danielsauter/quartz/README.md

# Quartz

### Hexo Source Code 

hexo init
hexo generate
hexo deploy
