danielsauter/quartz/source/README.md

# CNC
X Carve Documents and G-Code control

Folders
- GCODE : Testing files
- Models : CAD Files for XCarve. Built from 500mmX500mm model. Tolerances may vary.
- Scripts : Python & Grasshopper files
- UniversalGCodeSender : To manually send GCode to XCarve

Next tests:
- Faulty Y Limit Switch
- Movement in 3D
- Make 3D Printer mount**
- Extruder to GRBL Connections*

Base plate & temperature controller

*Difficulty/Time Investment
