danielsauter/quartz/source/_posts/4- CAD Models.md

---
title: CAD Models
date: 6/4/2016
---
<!-- more -->
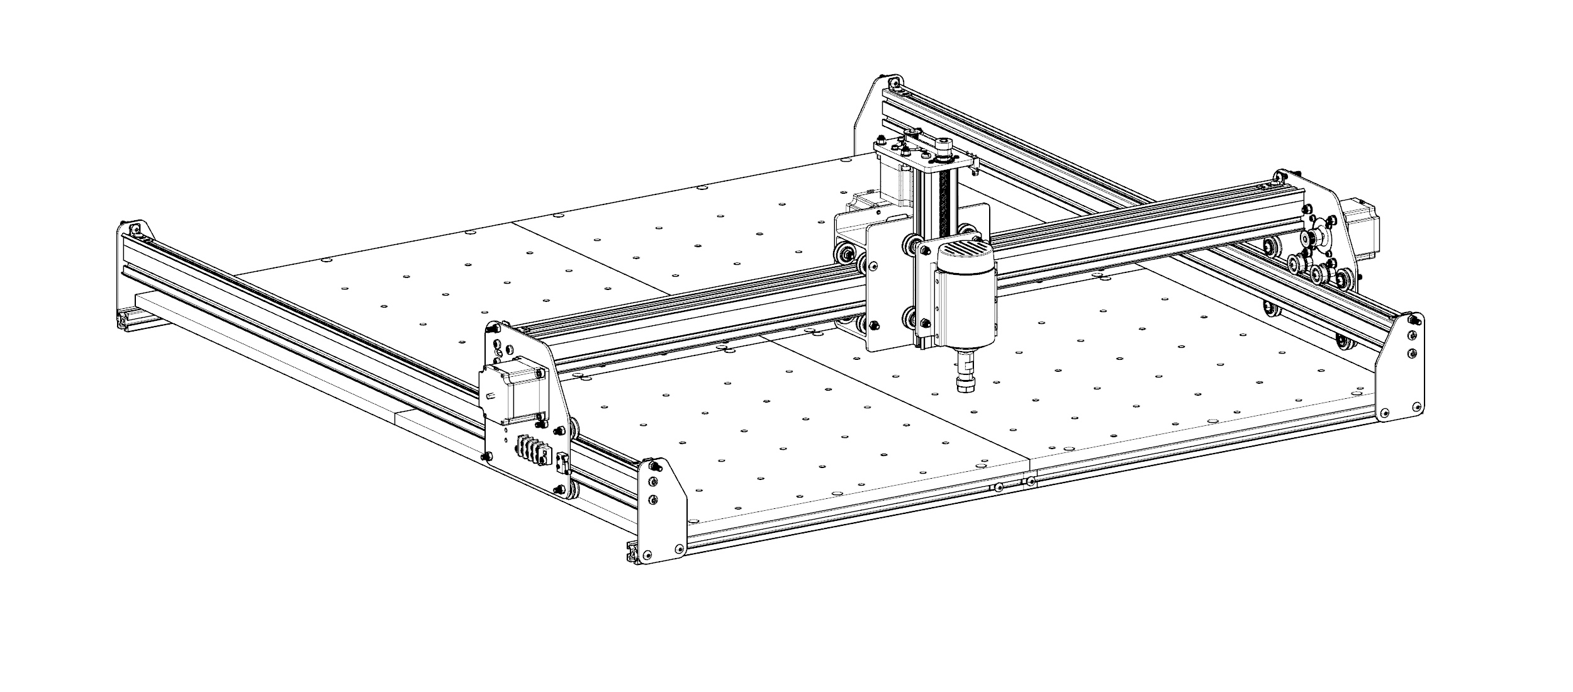
[picture p3: source/images/XCarve1000.jpg]


# X Carve 1000mm

The model for the X-Carve 1000mm and its parts is available on [GrabCAD Workbench](https://workbench.grabcad.com/workbench/projects/gcl5zpCuwqCXWLvYktLQBc-2IHvossNo37ycTOkzg6gREW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)

* * *

# Extruder Original CAD
The reference file for the 3D printer extruder was taken from [GrabCAD Library](https://grabcad.com/library/china-extruder-for-3d-printer-from-aliexpress-1)

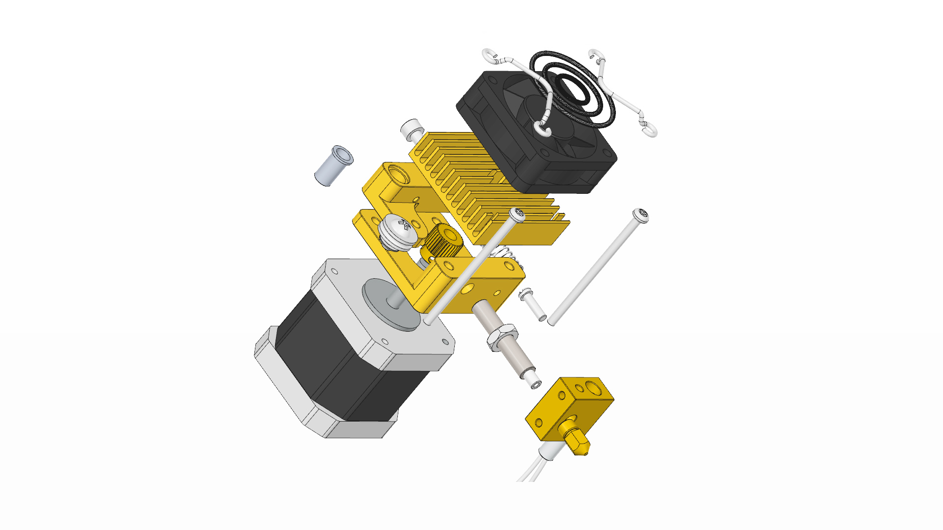
[picture p4: source/images/Extruder grabcad.jpg]
GrabCad Extruder


* * *

# Extruder Modification
The extruder will require to be machined in order to enlarge the feed and extrusion openings. More details can be found in the linked CAD files. It is highly recommended to carry out your own measurements specific to the extruder you own. These drawings are intended to provide a guide to share the required modifications. 
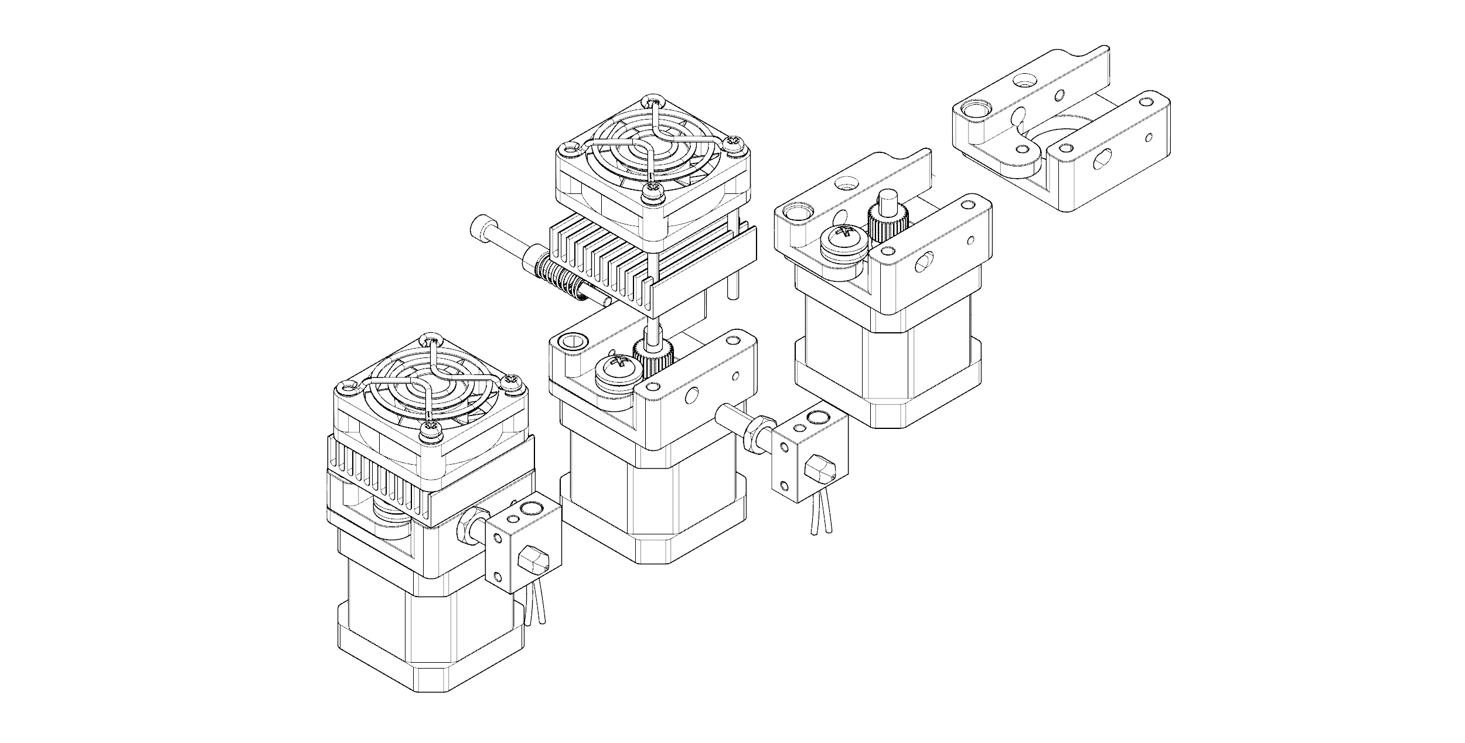
[picture p5: source/images/Extruder Mod.jpg]
Extruder Modified

<iframe width="100%" height="480" src="https://sketchfab.com/models/ec986721a17f40f2b00fd561553fb349/embed" frameborder="0" allowfullscreen mozallowfullscreen="true" webkitallowfullscreen="true" onmousewheel=""></iframe>

[Download .3dm Rhino File](https://www.dropbox.com/s/v5pvn5o80edqq0c/extruder%20mod.3dm?dl=0)
[Download .stp Rhino File (without annotations)](https://www.dropbox.com/s/hwm30xc2ja88o7x/extruder%20mod.stp?dl=0)

* * *

# Aluminium Mounts for the Extruder
You'll need some basic experience for Lathe Machining. Please sought help from a workshop technician for extra help. The drawings are annotated with measurements in Rhino file. They may vary depending upon the model of your extruder and the glass rods you own. Again, these are closest possible representation of the hardware setup.
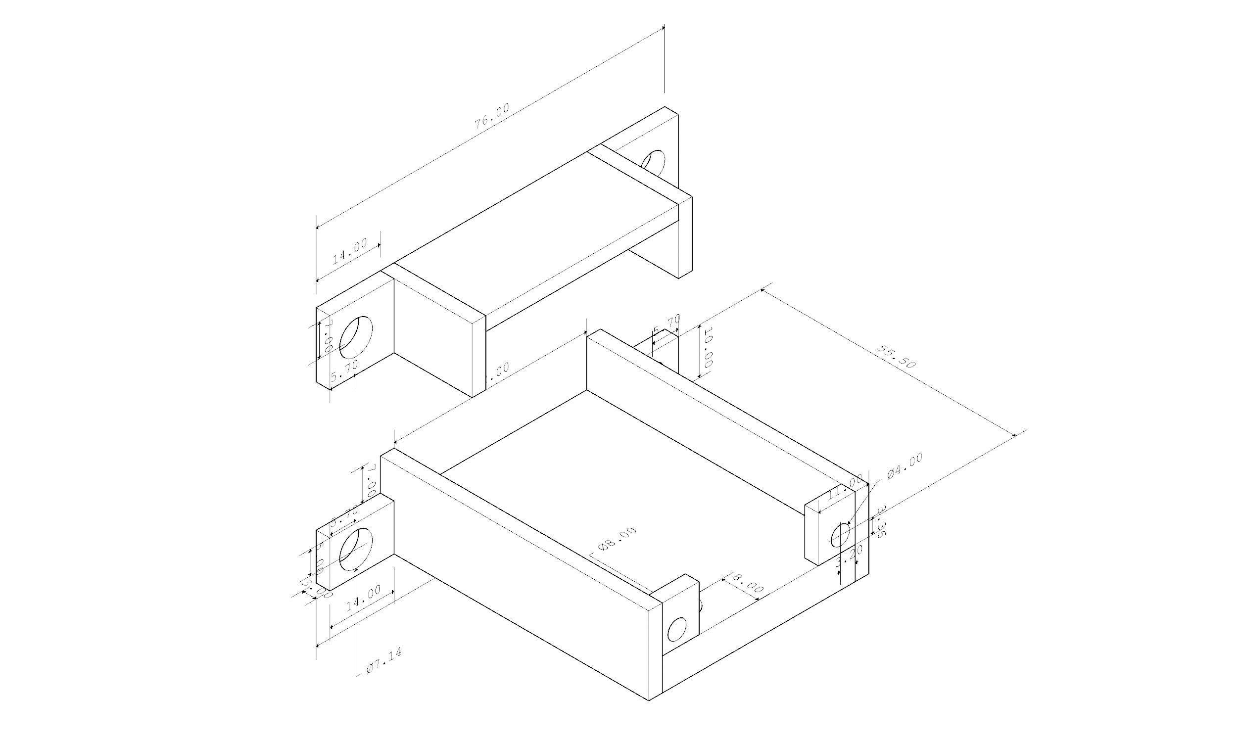
[picture p6: source/images/extruder mount.jpg]
Extruder Mount


<iframe width="100%" height="480" src="https://sketchfab.com/models/8a998a0730a74d8391d096257696d2f6/embed" frameborder="0" allowfullscreen mozallowfullscreen="true" webkitallowfullscreen="true" onmousewheel=""></iframe>

[Download .3dm Rhino File](https://www.dropbox.com/s/8g3itv43fneh8n2/extruder%20mount.3dm?dl=0)
[Download .stp Rhino File (without annotations)](https://www.dropbox.com/s/jf1a3pl2my2fpgk/extruder%20mount.stp?dl=0)

* * *

# Final Assembly
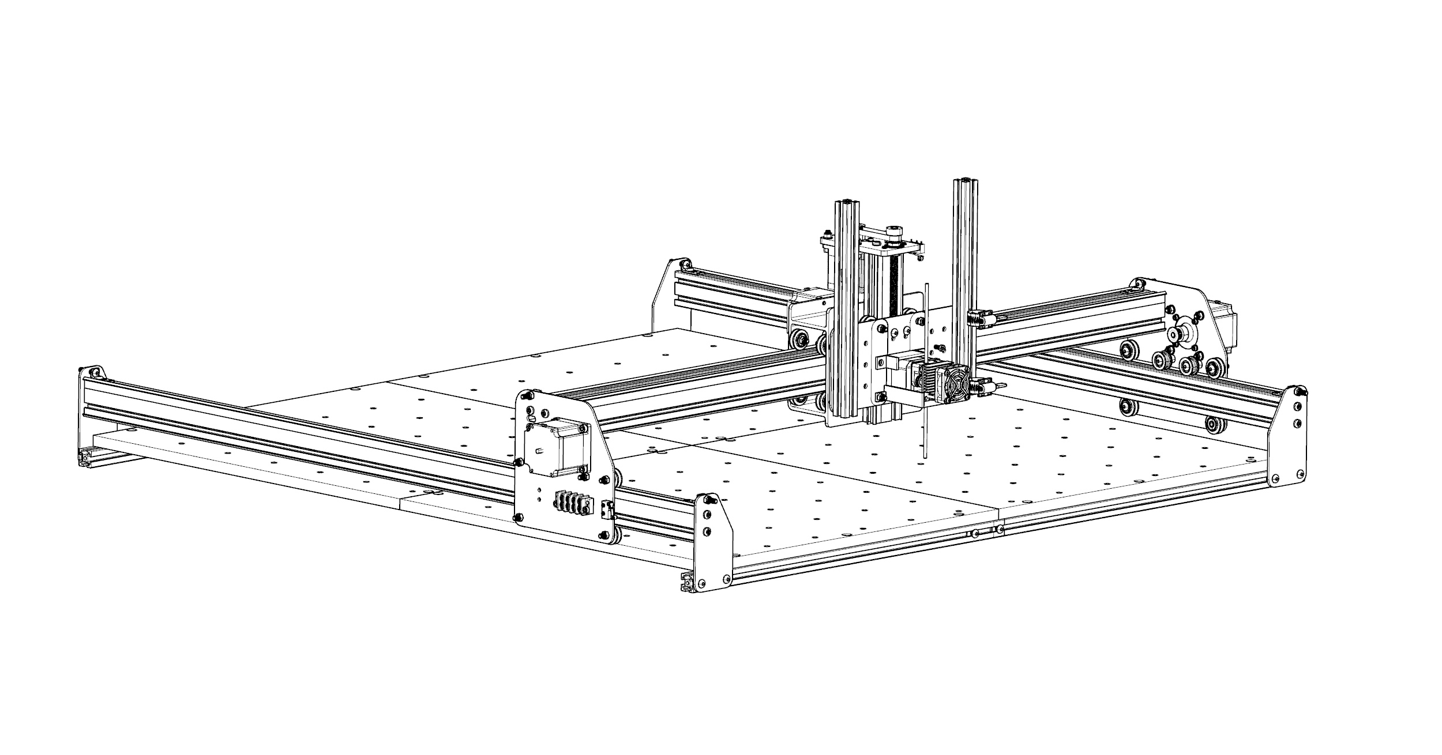
[picture p7: source/images/XCarve1000 mod.jpg]

[Download .3dm Rhino File](https://www.dropbox.com/s/xrf9nrrtaag5o8s/Xcarve_mod.3dm?dl=0)
