danielsauter/quartz/source/images/DSC08460.JPG

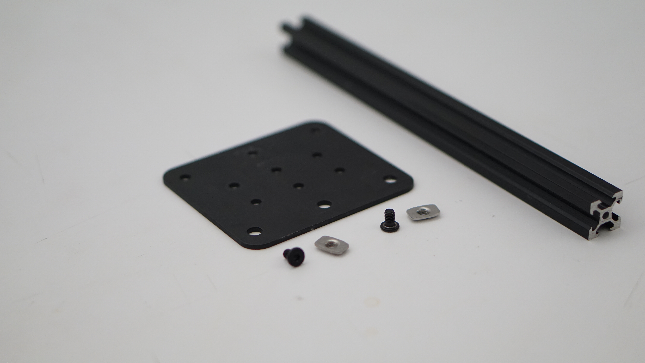
source/images/DSC08460.JPG
