danielsauter/quartz/source/images/DSC08463.JPG

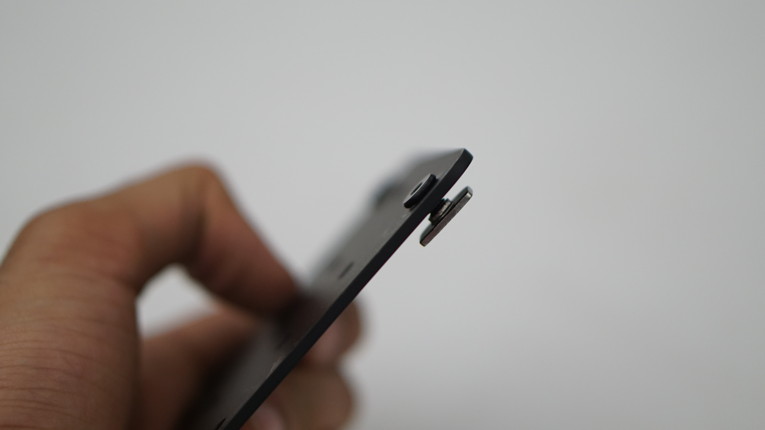
source/images/DSC08463.JPG
