danielsauter/quartz/source/images/DSC08465.JPG

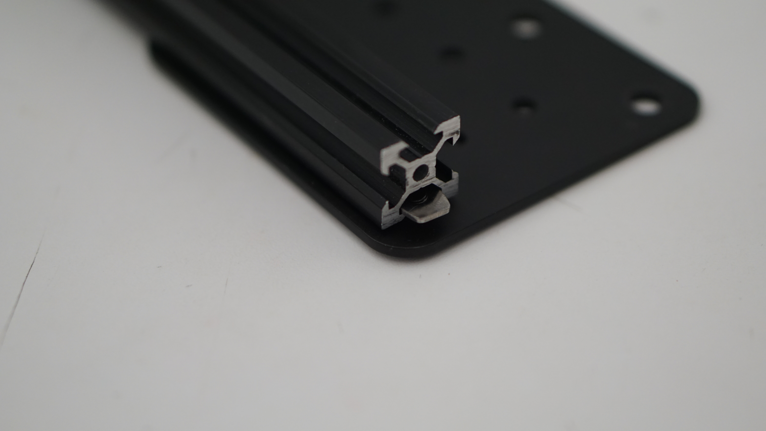
source/images/DSC08465.JPG
