danielsauter/quartz/source/images/DSC08470.JPG

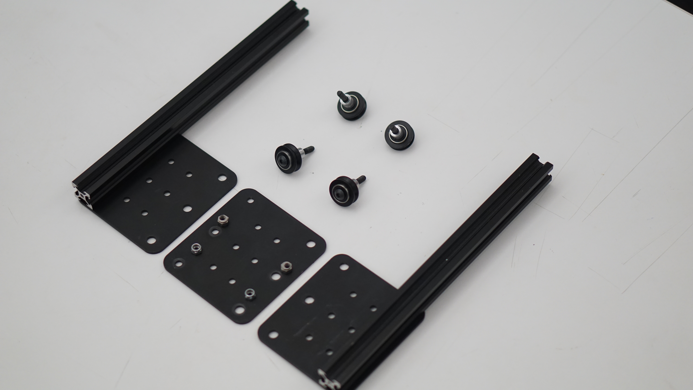
source/images/DSC08470.JPG
