danielsauter/quartz/source/images/DSC08473.JPG

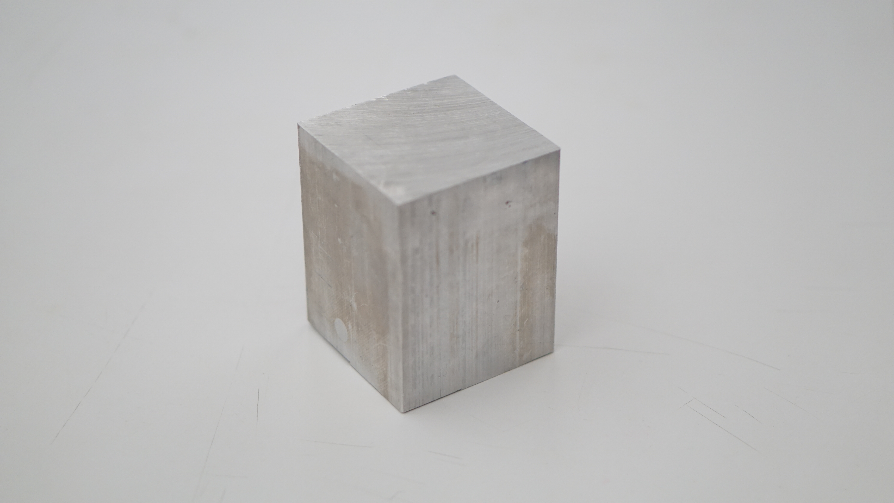
source/images/DSC08473.JPG
