danielsauter/quartz/source/images/DSC08480.JPG

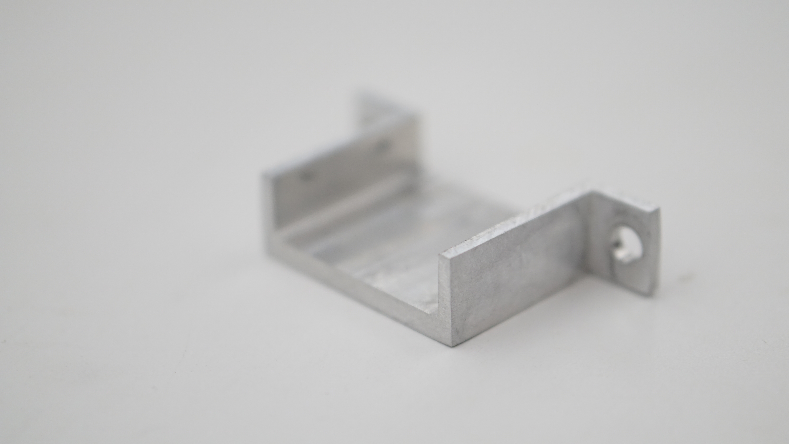
source/images/DSC08480.JPG
