danielsauter/quartz/source/images/DSC08518.JPG

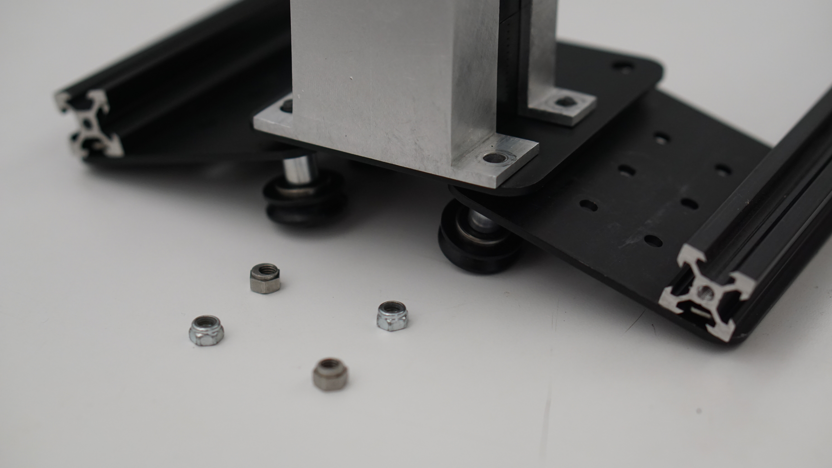
source/images/DSC08518.JPG
