danielsauter/quartz/source/images/DSC08522.jpg

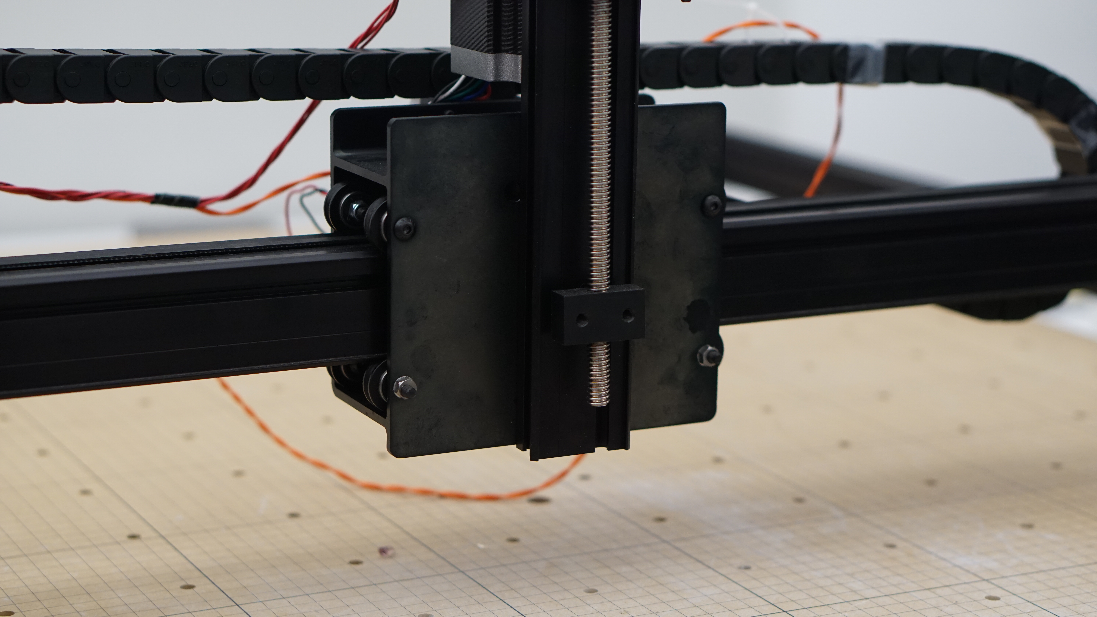
source/images/DSC08522.jpg
