danielsauter/quartz/source/images/DSC08523.JPG

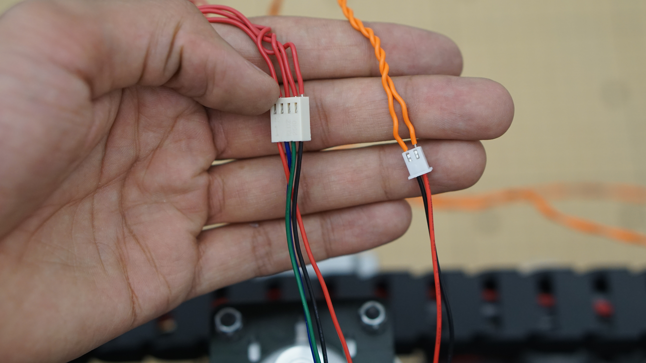
source/images/DSC08523.JPG
