danielsauter/quartz/source/images/DSC08533.JPG

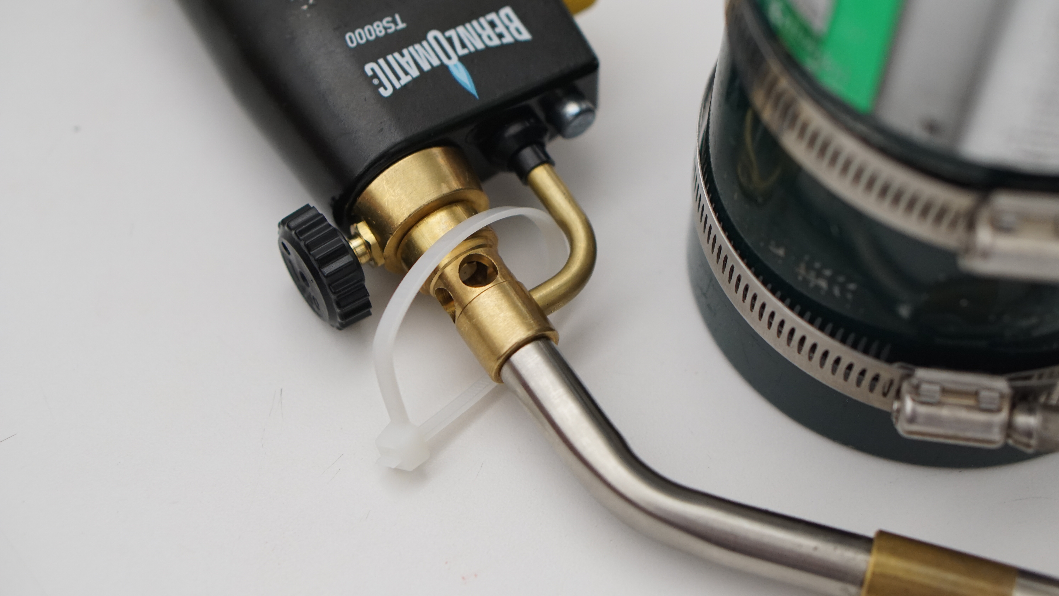
source/images/DSC08533.JPG
