danielsauter/quartz/source/images/DSC08534.JPG

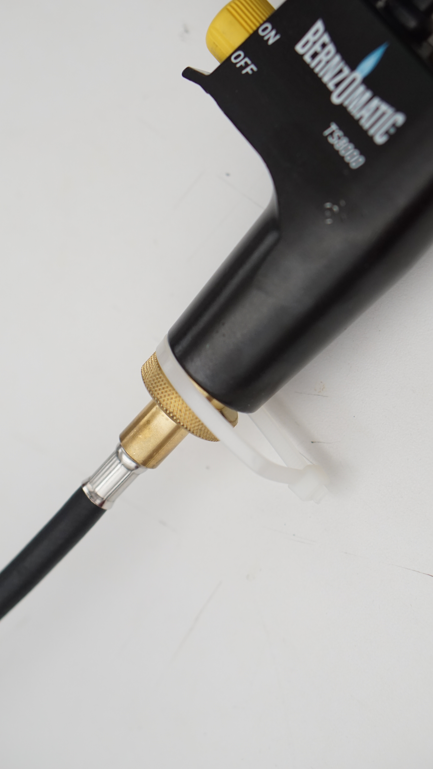
source/images/DSC08534.JPG
