danielsauter/quartz/source/images/DSC08536.JPG

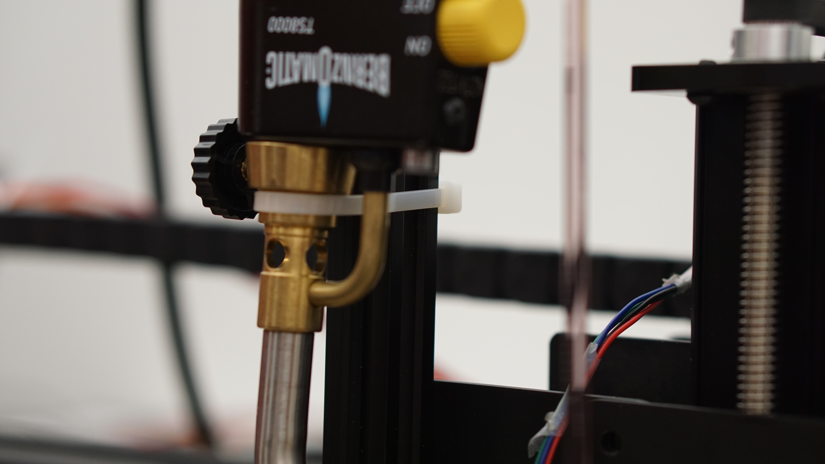
source/images/DSC08536.JPG
