danielsauter/quartz/source/images/DSC08538.JPG

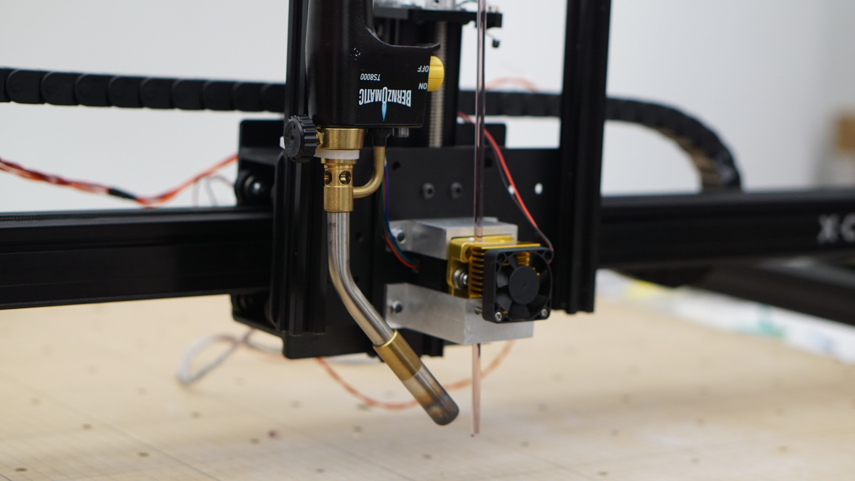
source/images/DSC08538.JPG
