danielsauter/quartz/source/images/DSC08548.JPG

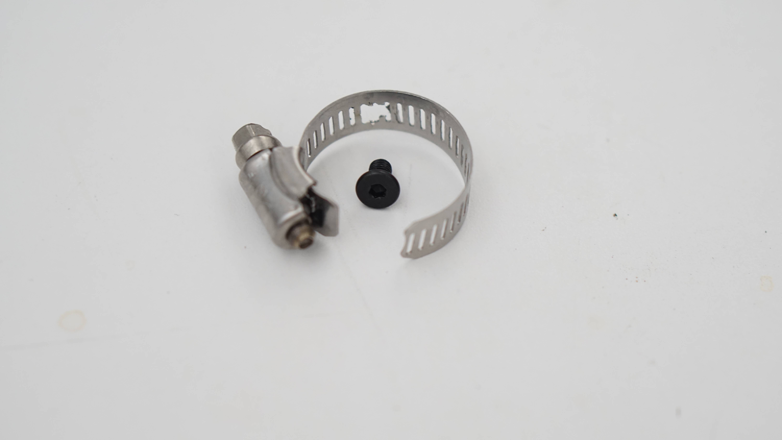
source/images/DSC08548.JPG
