danielsauter/quartz/source/images/DSC08551.JPG

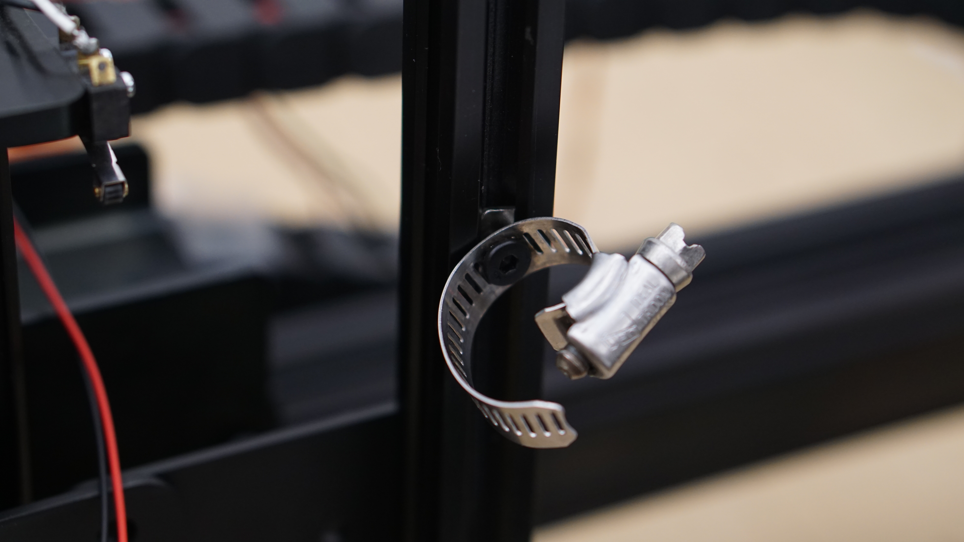
source/images/DSC08551.JPG
