danielsauter/quartz/source/images/DSC08552.JPG

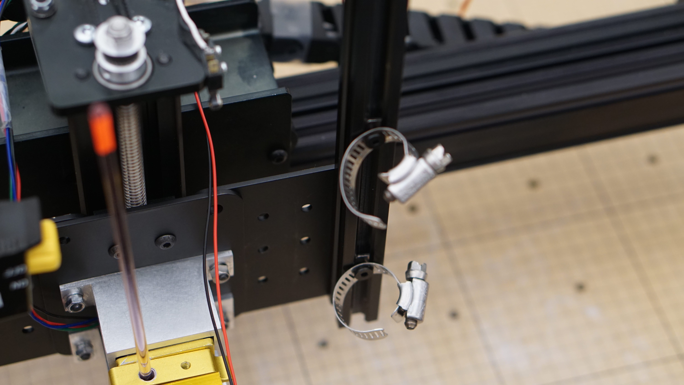
source/images/DSC08552.JPG
