danielsauter/quartz/source/images/extruder5.jpg

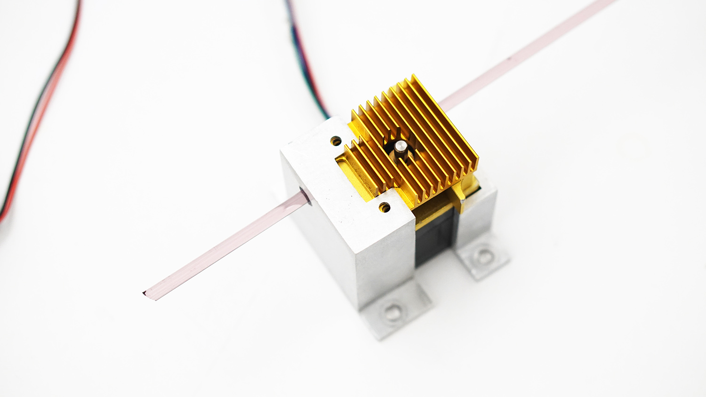
source/images/extruder5.jpg
