danielsauter/quartz/source/images/extruder6.jpg

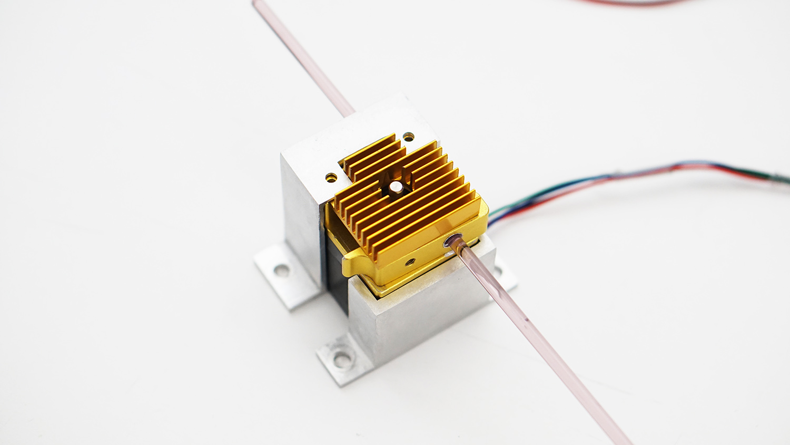
source/images/extruder6.jpg
