danielsauter/quartz/source/images/extruder7.jpg

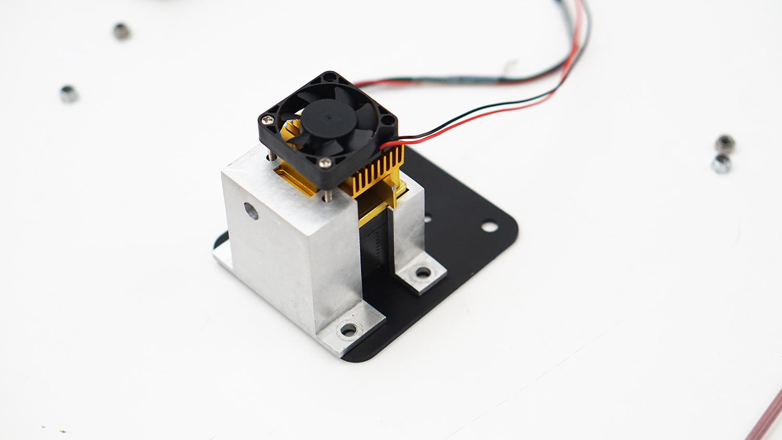
source/images/extruder7.jpg
