danielsauter/quartz/source/images/intro1.jpg

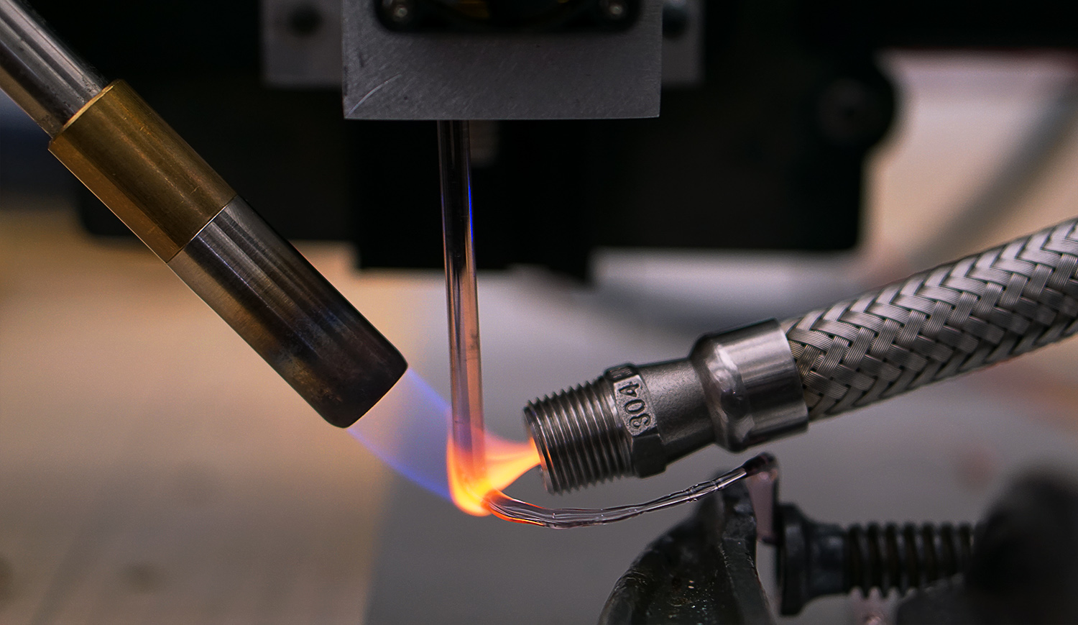
source/images/intro1.jpg
