danielsauter/quartz/source/images/tinyg.jpg

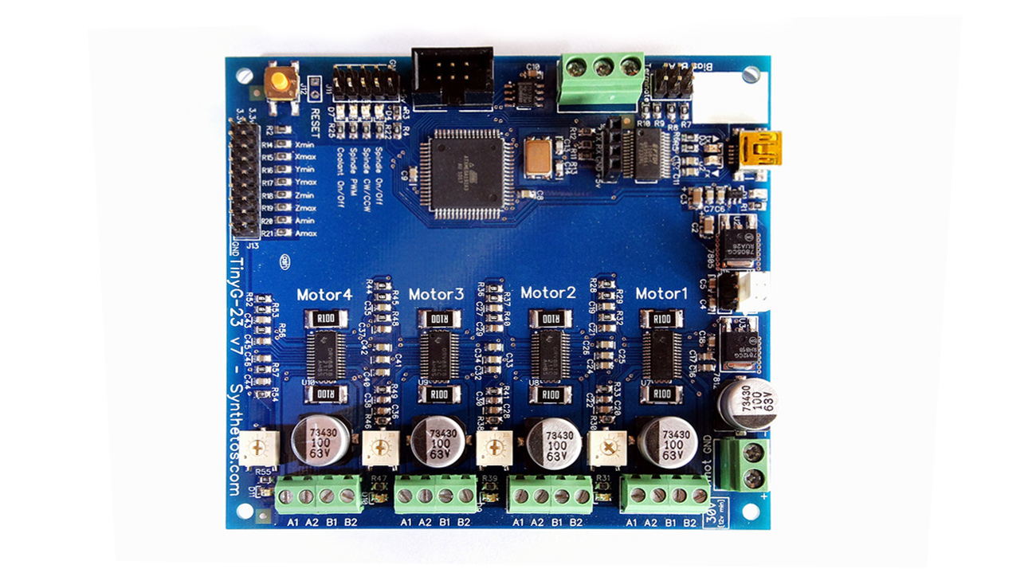
source/images/tinyg.jpg
