danielsauter/quartz/source/_posts/3- Parts List.md

---
title: Parts List
date: 6/5/2016
---

- [X-Carve Machine](https://www.inventables.com/technologies/x-carve/customize#fully-loaded)
	You may order one without the Spindle and Motion Controller.
	This project is based on following configuration:
	- 1000mm Rail Kit
	- ACME Lead Screw Kit

- [TinyG Motion Controller](http://synthetos.myshopify.com/products/tinyg)

- 3X [Spindle Mounting Plates](https://www.inventables.com/technologies/spindle-mounting-plate)
	- Part Number: 30287-01

- 1X [500mm Aluminum Extrusion](https://www.inventables.com/technologies/aluminum-extrusion-20mm-x-20mm-black)
	- Part Number: 26049-01
	- Manually cut in 250mm Halves

- 1X Pack of [Tslot screws](https://www.inventables.com/technologies/pre-assembly-t-slot-nuts)
	- Pitch: 0.5mm
	- Part Number: 25281-01
- 1X Pack of [Button Head Cap Screw](https://www.inventables.com/technologies/button-head-cap-screw?recommended=product)
	- Length: 16mm
	- Pitch: 0.5mm
	- Part Number: 25286-11

- 1X Pack of [Nylon Insert Lock Nut](https://www.inventables.com/technologies/nylon-insert-lock-nut)
	- Part Number: 30265-02
	- Pitch: 0.5mm

- [Multipurpose 6061 Aluminum](http://www.mcmaster.com/#9008k62/=1165kyw) ( Link to CAD Models)
	- Rectangular Bar 3"x3"x6"
	- Part Number: 9008K62

- [3D printer Extruder](https://www.amazon.com/Sintron-Printer-Extruder-Upgrade-MakerBot/dp/B00SLL9OO8/189-9506836-5291546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)

- 1X [Seat washer](http://www.homedepot.com/p/DANCO-1-4-in-Faucet-Seat-Washers-for-Price-Pfister-80359/203193501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)
	- 1/4" Faucet Seat Washer
	- Model Number: 80359
	- Part Number: 711262

- [Glass rods](http://www.mcmaster.com/#8496k22/=12wav0h)
	- Part Number: 8496K22
	- *This project used a locally sourced sampler set of approximately same specifications.
 
- [Vaccon Ventrui Pump](http://www.vaccon.com/CDF-Home.aspx)
	- Model Number: CDF-375H
	- Silencer Optional

- NPT Fittings (May be available in local hardware stores)
	- [Watts LFA-16 Compression Coupling](https://www.amazon.com/Watts-LFA16-Compression-Female-Adapter/dp/B004VT3ZYO)
		- 1/4" OD x 1/4" FIP
	- [Industrial Shape Hose Coupling](http://www.mcmaster.com/#6718K26)
		- 1/4" NPTF Male
		- Part Number: 6718K26
	- [AllstarBrass Straight Inverted Flare Female Brake Line Adapter Fitting](https://www.amazon.com/gp/product/B006K8MH2U/ref=od_aui_detailpages00?ie=UTF8&psc=1)
		- 1/8" NPT Male to 1/4" 
		- Part Number: ALL50121 

- [High Temperature Corrosion Resistant Braided Hose](http://www.mcmaster.com/#5680K12)
	- Flexible, 3/8 NPT Male Fittings
	- Part Number: 5680K12
	- Length 72" and up

- [Propane Tank](http://www.bernzomatic.com/product/ts916-16-4-oz-propane-camping-cylinder/)
	- Model: TX-916
- [Trigger Start Torch](http://www.bernzomatic.com/product/ts8000bzkc-high-intensity-trigger-start-torch-kit/)
	- Model: TS8000BZKC

- 1X Pack [Hose Clamps](http://www.mcmaster.com/#5362k12/=12wbx5l)
	- 3/4" ID
	- Part Number: 5362K12

- G-Clamps 

- Zipties

- [Air Compressor](https://www.amazon.com/PORTER-CABLE-C3151-OILFREE-COMPRESSOR/dp/B001DUNC3I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)
	- Model Number: Porter-Cable C3151
	- Capacity: 4.5 GALLON 150 PSI 

Notes: 
These parts are an indication of what was used and tested during the documentation of this project. Feel free to experiment with different designs and materials.
