danielsauter/quartz/(list of files, cad)

Other CAD files:
Scripts/Grasshopper Shopbot Writer/Dimple_halftone_outline.3dm
