danielsauter/quartz/source/images/Assemble (3).JPG

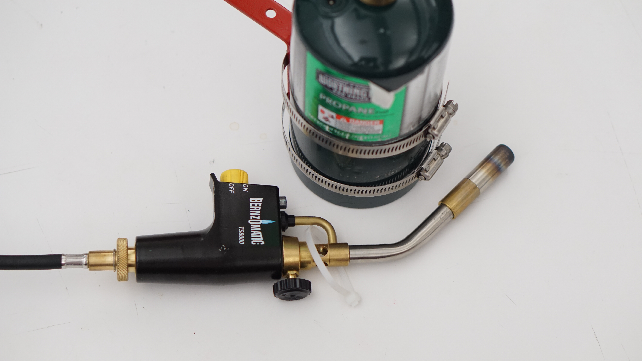
source/images/Assemble (3).JPG
